nospam2000/Greaseweazle-F7-Plus/(list of files, drawings)

Other design files:
V2/Greaseweazle_F7_Plus_V2.dsn
