nospam2000/Greaseweazle-F7-Plus/V2/Greaseweazle_F7_Plus_V2.kicad_pcb

## KiCad design V2/Greaseweazle_F7_Plus_V2.kicad_pcb (2021-01-13)

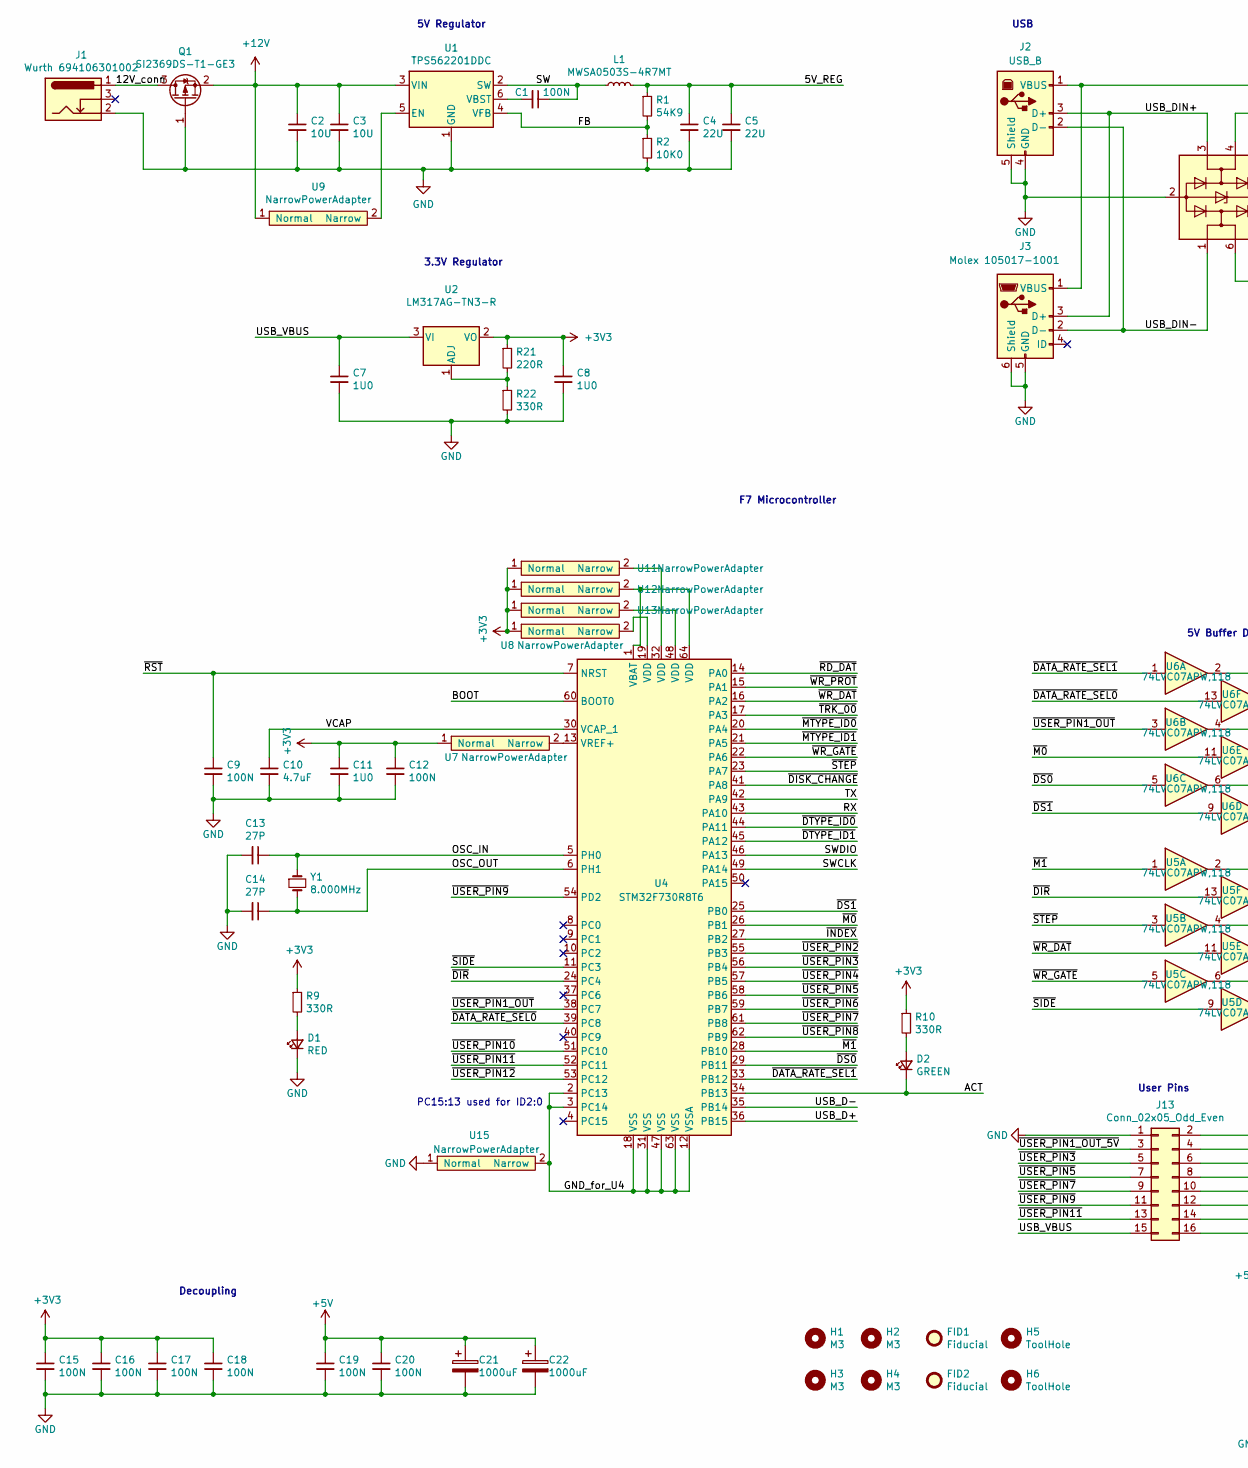
[picture p1: schematic Greaseweazle_F7_Plus_V2.sch, Greaseweazle F7 Plus, part in row 1, column 1]

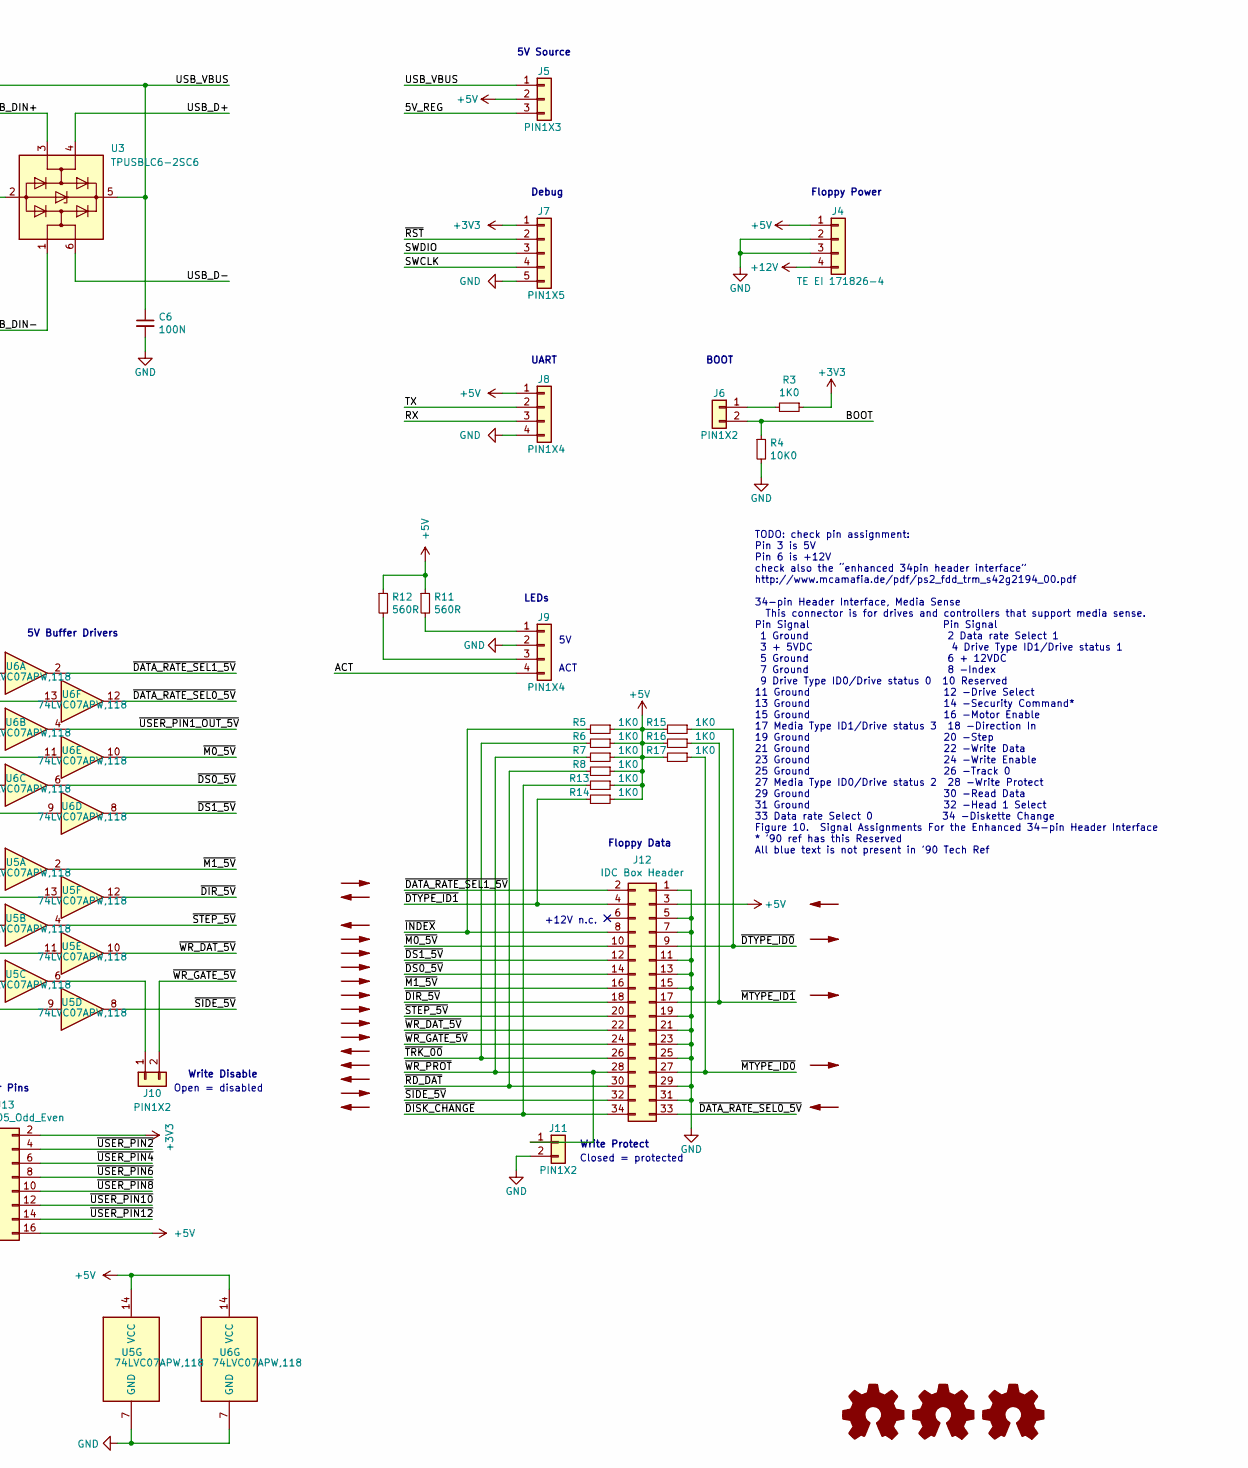
[picture p2: schematic Greaseweazle_F7_Plus_V2.sch, Greaseweazle F7 Plus, part in row 1, column 2]

Parts:
C1, C6, C9, C12, C15, C16, C17, C18, C19, C20: 100N; C_0402_1005Metric; MFR.Part CL05B104KO5NNNC; LCSC C1525
C2, C3: 10U; C_0805_2012Metric; MFR.Part CL21A106KAYNNNE; LCSC C15850
C4, C5: 22U; C_0805_2012Metric; MFR.Part CL21A226MAQNNNE; LCSC C45783
C7, C8, C11: 1U0; C_0402_1005Metric; MFR.Part CL05A105KA5NQNC; LCSC C52923
C10: 4.7uF; C_0805_2012Metric; MFR.Part CL21A475KAQNNNE; LCSC C1779
C13, C14: 27P; C_0402_1005Metric; MFR.Part 0402CG270J500NTN; LCSC C1557
C21, C22: 1000uF; CP_Radial_D10.0mm_P5.00mm
D1: RED; LED_0603_1608Metric; MFR.Part KT-0603R; LCSC C2286
D2: GREEN; LED_0603_1608Metric; MFR.Part 19-217/GHC-YR1S2/3T; LCSC C72043
FID1, FID2: Fiducial; Fiducial_1mm_Mask2mm
H1, H2, H3, H4: M3; MountingHole_3mm
H5, H6: ToolHole; ToolingHole_1.152mm
J1: Wurth 694106301002; BarrelJack_Horizontal
J2: USB_B; USB_B_OST_USB-B1HSxx_Horizontal
J3: Molex 105017-1001; USB_Micro-B_Molex-105017-0001
J4: TE EI 171826-4; TE_171826-4_1x4_P2.50mm_Horizontal
J5: PIN1X3; PinHeader_1x03_P2.54mm_Vertical
J6, J10, J11: PIN1X2; PinHeader_1x02_P2.54mm_Vertical
J7: PIN1X5; PinHeader_1x05_P2.54mm_Vertical
J8, J9: PIN1X4; PinHeader_1x04_P2.54mm_Vertical
J12: IDC Box Header; IDC-Header_2x17_P2.54mm_Vertical
J13: Conn_02x05_Odd_Even; PinHeader_2x08_P2.54mm_Vertical
L1: MWSA0503S-4R7MT; L_5.4x5.2_H2.8; MFR.Part MWSA0503S-4R7MT; LCSC C408410
LOGO1: OSHW Logo; OSHW-Logo2_7.3x6mm_SilkScreen
LOGO2: GW Logo; Greaseweazle_Logo_small
LOGO3: GW Logo; Symbol_Barrel_Polarity
Q1: SI2369DS-T1-GE3; SOT-23; MFR.Part SI2369DS-T1-GE3; LCSC C141546
R1: 54K9; R_0603_1608Metric; MFR.Part 0603WAF5492T5E; LCSC C23077
R2, R4: 10K0; R_0603_1608Metric; MFR.Part 0603WAF1002T5E; LCSC C25804
R3, R5, R6, R7, R8, R13, R14, R15, R16, R17: 1K0; R_0805_2012Metric; MFR.Part 0805W8F1001T5E; LCSC C17513
R9, R10, R22: 330R; R_0805_2012Metric; MFR.Part 0805W8F3300T5E; LCSC C17630
R11, R12: 560R; R_0805_2012Metric; MFR.Part 0805W8F5600T5E; LCSC C28636
R21: 220R; R_0805_2012Metric; MFR.Part 0805W8F2200T5E; LCSC C17557
U1: TPS562201DDC; SOT-23-6; MFR.Part TPS562201DDCR; LCSC C90061
U2: LM317AG-TN3-R; TO-252-2; MFR.Part LM317AG-TN3-R; LCSC C75510
U3: TPUSBLC6-2SC6; SOT-23-6; MFR.Part TPUSBLC6-2SC6; LCSC C558442
U4: STM32F730R8T6; LQFP-64_10x10mm_P0.5mm; MFR.Part STM32F730R8T6; LCSC C478453
U5, U6: 74LVC07APW,118; TSSOP-14_4.4x5mm_P0.65mm; MFR.Part 74LVC07APW,118; LCSC C6051
U7, U8, U9, U11, U12, U13: NarrowPowerAdapter; NarrowPowerAdapter_0.60_to_0.25
U15: NarrowPowerAdapter; NarrowPowerAdapter_0.60_to_0.25_thick
Y1: 8.000MHz; Crystal_SMD_5032-2Pin_5.0x3.2mm; MFR.Part X50328MSB2GI; LCSC C115962

Connections:
+3V3: C8.1, C11.1, C12.1, C15.1, C16.1, C17.1, C18.1, J7.1, J13.2, R3.1, R9.1, R10.1, R21.1, U2.2 (VO), U7.1 (Normal), U8.1 (Normal), U11.1 (Normal), U12.1 (Normal), U13.1 (Normal)
+5V: C19.1, C20.1, C21.1, C22.1, J4.1, J5.2, J8.1, J12.3, J13.16, R5.1, R6.1, R7.1, R8.1, R11.1, R12.1, R13.1, R14.1, R15.2, R16.2, R17.2, U5.14 (VCC), U6.14 (VCC)
+12V: C2.1, C3.1, J4.4, Q1.2 (S), U1.3 (VIN), U9.1 (Normal)
/5V_REG: C4.1, C5.1, J5.3, L1.2, R1.1
/12V_conn: J1.1, Q1.3 (D)
/ACT: D2.1 (K), J9.4, U4.34 (PB13)
/BOOT: J6.2, R4.1, U4.60 (BOOT0)
/FB: R1.2, R2.1, U1.4 (VFB)
/GND_for_U4: U4.2 (PC13), U4.3 (PC14), U4.12 (VSSA), U4.18 (VSS), U4.31 (VSS), U4.47 (VSS), U4.63 (VSS), U15.2 (Narrow)
/OSC_IN: C13.1, U4.5 (PH0), Y1.1
/OSC_OUT: C14.1, U4.6 (PH1), Y1.2
/RX: J8.3, U4.43 (PA10)
/SW: C1.1, L1.1, U1.2 (SW)
/SWCLK: J7.4, U4.49 (PA14)
/SWDIO: J7.3, U4.46 (PA13)
/TX: J8.2, U4.42 (PA9)
/USB_D+: U3.4 (I/O2), U4.36 (PB15)
/USB_D-: U3.6 (I/O1), U4.35 (PB14)
/USB_DIN+: J2.3 (D+), J3.3 (D+), U3.3 (I/O2)
/USB_DIN-: J2.2 (D-), J3.2 (D-), U3.1 (I/O1)
/USB_VBUS: C6.1, C7.1, J2.1 (VBUS), J3.1 (VBUS), J5.1, J13.15, U2.3 (VI), U3.5 (VBUS)
/VCAP: C10.1, U4.30 (VCAP_1)
/~DATA_RATE_SEL0_5V~: J12.33, U6.12
/~DATA_RATE_SEL0~: U4.39 (PC8), U6.13
/~DATA_RATE_SEL1_5V~: J12.2, U6.2
/~DATA_RATE_SEL1~: U4.33 (PB12), U6.1
/~DIR_5V~: J12.18, U5.12
/~DIR~: U4.24 (PC4), U5.13
/~DISK_CHANGE~: J12.34, R13.2, U4.41 (PA8)
/~DS0_5V~: J12.14, U6.6
/~DS0~: U4.29 (PB11), U6.5
/~DS1_5V~: J12.12, U6.8
/~DS1~: U4.25 (PB0), U6.9
/~DTYPE_ID0~: J12.9, R15.1, U4.44 (PA11)
/~DTYPE_ID1~: J12.4, R14.2, U4.45 (PA12)
/~INDEX~: J12.8, R5.2, U4.27 (PB2)
/~M0_5V~: J12.10, U6.10
/~M0~: U4.26 (PB1), U6.11
/~M1_5V~: J12.16, U5.2
/~M1~: U4.28 (PB10), U5.1
/~MTYPE_ID0~: J12.27, R17.1, U4.20 (PA4)
/~MTYPE_ID1~: J12.17, R16.1, U4.21 (PA5)
/~RD_DAT~: J12.30, R8.2, U4.14 (PA0)
/~RST~: C9.1, J7.2, U4.7 (NRST)
/~SIDE_5V~: J12.32, U5.8
/~SIDE~: U4.11 (PC3), U5.9
/~STEP_5V~: J12.20, U5.4
/~STEP~: U4.23 (PA7), U5.3
/~TRK_00~: J12.26, R6.2, U4.17 (PA3)
/~USER_PIN1_OUT_5V~: J13.3, U6.4
/~USER_PIN1_OUT~: U4.38 (PC7), U6.3
/~USER_PIN2~: J13.4, U4.55 (PB3)
/~USER_PIN3~: J13.5, U4.56 (PB4)
/~USER_PIN4~: J13.6, U4.57 (PB5)
/~USER_PIN5~: J13.7, U4.58 (PB6)
/~USER_PIN6~: J13.8, U4.59 (PB7)
/~USER_PIN7~: J13.9, U4.61 (PB8)
/~USER_PIN8~: J13.10, U4.62 (PB9)
/~USER_PIN9~: J13.11, U4.54 (PD2)
/~USER_PIN10~: J13.12, U4.51 (PC10)
/~USER_PIN11~: J13.13, U4.52 (PC11)
/~USER_PIN12~: J13.14, U4.53 (PC12)
/~WR_DAT_5V~: J12.22, U5.10
/~WR_DAT~: U4.16 (PA2), U5.11
/~WR_GATE_5V~: J10.2, J12.24
/~WR_GATE~: U4.22 (PA6), U5.5
/~WR_PROT~: J11.1, J12.28, R7.2, U4.15 (PA1)
GND: C2.2, C3.2, C4.2, C5.2, C6.2, C7.2, C8.2, C9.2, C10.2, C11.2, C12.2, C13.2, C14.2, C15.2, C16.2, C17.2, C18.2, C19.2, C20.2, C21.2, C22.2, D1.1 (K), J1.2, J2.4 (GND), J2.5 (Shield), J3.5 (GND), J3.6 (Shield), J4.2, J4.3, J7.5, J8.4, J9.2, J11.2, J12.1, J12.5, J12.7, J12.11, J12.13, J12.15, J12.19, J12.21, J12.23, J12.25, J12.29, J12.31, J13.1, Q1.1 (G), R2.2, R4.2, R22.2, U1.1 (GND), U3.2 (GND), U5.7 (GND), U6.7 (GND), U15.1 (Normal)
unnamed: C1.2, U1.6 (VBST)
unnamed: D1.2 (A), R9.2
unnamed: D2.2 (A), R10.2
unnamed: J6.1, R3.2
unnamed: J9.1, R11.2
unnamed: J9.3, R12.2
unnamed: J10.1, U5.6
unnamed: R21.2, R22.1, U2.1 (ADJ)
unnamed: U1.5 (EN), U9.2 (Narrow)
unnamed: U4.13 (VREF+), U7.2 (Narrow)
unnamed: U4.19 (VDD), U8.2 (Narrow)
unnamed: U4.32 (VDD), U11.2 (Narrow)
unnamed: U4.1 (VBAT), U4.64 (VDD), U12.2 (Narrow)
unnamed: U4.48 (VDD), U13.2 (Narrow)

Notes on the sheet:
UART
Debug
Floppy Power
BOOT
USB
Floppy Data
5V Regulator
5V Buffer Drivers
3.3V Regulator
5V Source
F7 Microcontroller
Decoupling
LEDs
PC15:13 used for ID2:0
ACT
Write Protect
Write Disable
Open = disabled
Closed = protected
TODO: check pin assignment: Pin 3 is 5V Pin 6 is +12V check also the “enhanced 34pin header interface” http://www.mcamafia.de/pdf/ps2_fdd_trm_s42g2194_00.pdf 34-pin Header Interface, Media Sense This connector is for drives and controllers that support media sense. Pin Signal Pin Signal 1 Ground 2 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
+12V n.c.
User Pins

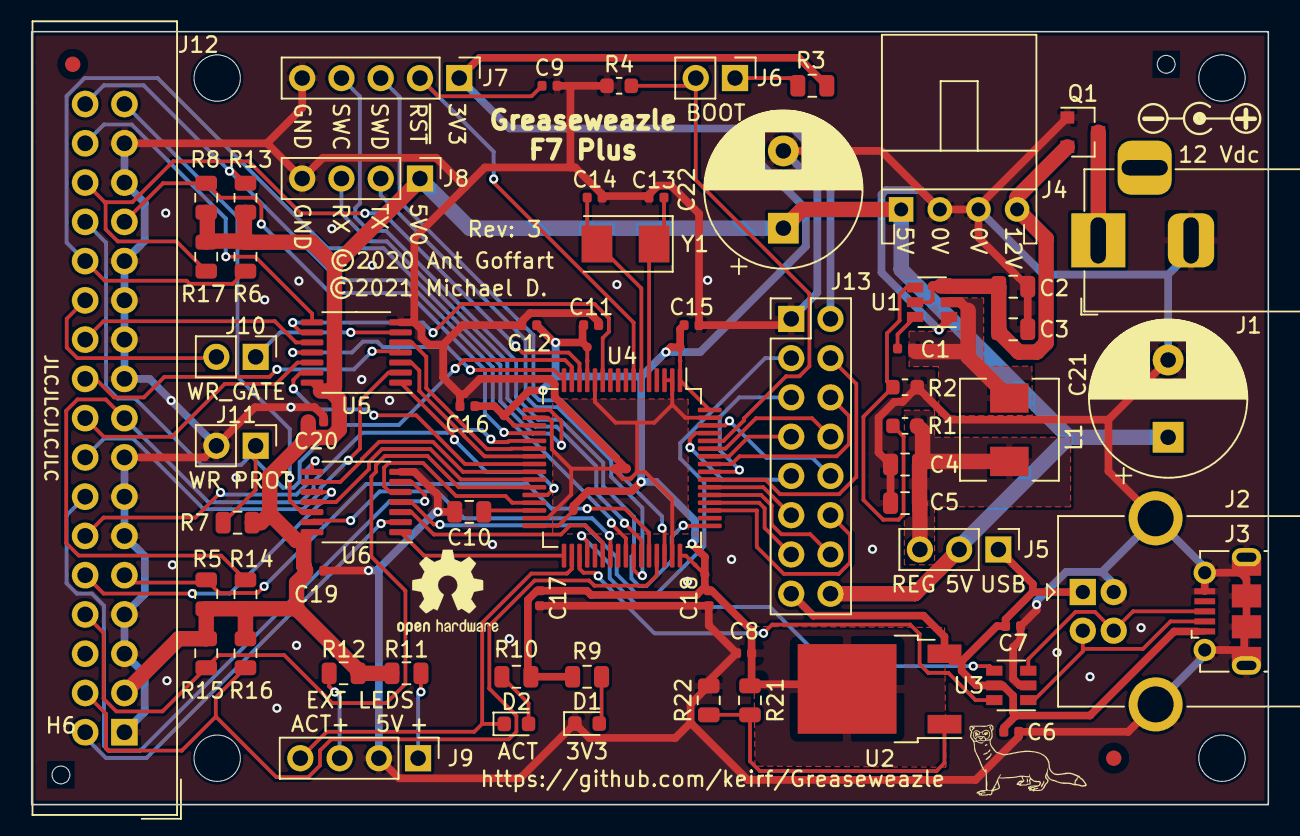
[picture p3: board Greaseweazle_F7_Plus_V2.kicad_pcb from above]

Board: 2 copper layers, 80.0 x 50.0 mm, 83 parts (0 on the bottom side), 82 nets.
