nospam2000/Greaseweazle-F7-Plus/(commit log)

2021-01-06 added JLCPBC component ids, adapted footprints changed components which are no available in JLCPCB catalog
    [Greaseweazle_F7_Plus_V2.sch, Greaseweazle_F7_Plus_V2_BOM.csv]
2021-01-07 made autorouting possible use components which are in stock on JLCPCB
    [Greaseweazle_F7_Plus_V2-B_Cu.gbr, Greaseweazle_F7_Plus_V2-B_Mask.gbr, Greaseweazle_F7_Plus_V2-Edge_Cuts.gbr, Greaseweazle_F7_Plus_V2-F_Cu.gbr, Greaseweazle_F7_Plus_V2-F_Mask.gbr, Greaseweazle_F7_Plus_V2-F_Paste.gbr, Greaseweazle_F7_Plus_V2-F_SilkS.gbr, Greaseweazle_F7_Plus_V2-NPTH.drl]
2021-01-07 fixed rotation of U3
    [Greaseweazle_F7_Plus_V2-top-pos_fixed.csv]
2021-01-08 fixed copper fill zones
    [Greaseweazle_F7_Plus_V2-B_Cu.gbr, Greaseweazle_F7_Plus_V2-B_Mask.gbr, Greaseweazle_F7_Plus_V2-Edge_Cuts.gbr, Greaseweazle_F7_Plus_V2-F_Cu.gbr, Greaseweazle_F7_Plus_V2-F_Mask.gbr, Greaseweazle_F7_Plus_V2-F_Paste.gbr, Greaseweazle_F7_Plus_V2-F_SilkS.gbr, Greaseweazle_F7_Plus_V2-NPTH.drl]
2021-01-08 decreased keep out area around tooling holes
    [Greaseweazle_F7_Plus_V2.kicad_pcb]
2021-01-08 changed copper zone pad connection of L1 to "thermal reliefs"
    [Greaseweazle_F7_Plus_V2.kicad_pcb]
2021-01-08 added copper fill below mcu and L1 improved power connections of mcu
    [Greaseweazle_F7_Plus_V2.dsn, Greaseweazle_F7_Plus_V2.kicad_pcb, Greaseweazle_F7_Plus_V2.sch]
2021-01-08 added via to get better copper fill made 5Vreg thicker
    [Greaseweazle_F7_Plus_V2.kicad_pcb]
2021-01-08 updated production output files
    [Greaseweazle_F7_Plus_V2-B_Cu.gbr, Greaseweazle_F7_Plus_V2-B_Mask.gbr, Greaseweazle_F7_Plus_V2-Edge_Cuts.gbr, Greaseweazle_F7_Plus_V2-F_Cu.gbr, Greaseweazle_F7_Plus_V2-F_Mask.gbr, Greaseweazle_F7_Plus_V2-F_Paste.gbr, Greaseweazle_F7_Plus_V2-F_SilkS.gbr, Greaseweazle_F7_Plus_V2-NPTH.drl]
2021-01-09 changed C10 from 10u to 4.7u according to STM doc changed 74LS07 to 74LVC07APW,118 to reduce cost
    [Greaseweazle_F7_Plus_V2.dsn, Greaseweazle_F7_Plus_V2.kicad_pcb, Greaseweazle_F7_Plus_V2.sch]
2021-01-09 routed latest version
    [Greaseweazle_F7_Plus_V2.kicad_pcb]
2021-01-09 production files for latest version
    [Greaseweazle_F7_Plus_V2-B_Cu.gbr, Greaseweazle_F7_Plus_V2-B_Mask.gbr, Greaseweazle_F7_Plus_V2-Edge_Cuts.gbr, Greaseweazle_F7_Plus_V2-F_Cu.gbr, Greaseweazle_F7_Plus_V2-F_Mask.gbr, Greaseweazle_F7_Plus_V2-F_Paste.gbr, Greaseweazle_F7_Plus_V2-F_SilkS.gbr, Greaseweazle_F7_Plus_V2-NPTH.drl]
2021-01-09 replaced 3.3V regulator by cheaper one moved many parts to make space
    [Greaseweazle_F7_Plus_V2-B_Cu.gbr, Greaseweazle_F7_Plus_V2-B_Mask.gbr, Greaseweazle_F7_Plus_V2-Edge_Cuts.gbr, Greaseweazle_F7_Plus_V2-F_Cu.gbr, Greaseweazle_F7_Plus_V2-F_Mask.gbr, Greaseweazle_F7_Plus_V2-F_Paste.gbr, Greaseweazle_F7_Plus_V2-F_SilkS.gbr, Greaseweazle_F7_Plus_V2-NPTH.drl]
2021-01-09 added 2nd CMT file to remove 5V regulator to save cost rotated U2 back by 180° added vias to get better copperfill
    [Greaseweazle_F7_Plus_V2-B_Cu.gbr, Greaseweazle_F7_Plus_V2-B_Mask.gbr, Greaseweazle_F7_Plus_V2-Edge_Cuts.gbr, Greaseweazle_F7_Plus_V2-F_Cu.gbr, Greaseweazle_F7_Plus_V2-F_Mask.gbr, Greaseweazle_F7_Plus_V2-F_Paste.gbr, Greaseweazle_F7_Plus_V2-F_SilkS.gbr, Greaseweazle_F7_Plus_V2-NPTH.drl]
2021-01-09 added 3x 10000uF caps to buffer motor start of floppy which can draw up to 1A
    [Greaseweazle_F7_Plus_V2-B_Cu.gbr, Greaseweazle_F7_Plus_V2-B_Mask.gbr, Greaseweazle_F7_Plus_V2-Edge_Cuts.gbr, Greaseweazle_F7_Plus_V2-F_Cu.gbr, Greaseweazle_F7_Plus_V2-F_Mask.gbr, Greaseweazle_F7_Plus_V2-F_Paste.gbr, Greaseweazle_F7_Plus_V2-F_SilkS.gbr, Greaseweazle_F7_Plus_V2-NPTH.drl]
2021-01-09 fixed copyright and greaseweazel silk
    [Greaseweazle_F7_Plus_V2-B_Cu.gbr, Greaseweazle_F7_Plus_V2-B_Mask.gbr, Greaseweazle_F7_Plus_V2-Edge_Cuts.gbr, Greaseweazle_F7_Plus_V2-F_Cu.gbr, Greaseweazle_F7_Plus_V2-F_Mask.gbr, Greaseweazle_F7_Plus_V2-F_Paste.gbr, Greaseweazle_F7_Plus_V2-F_SilkS.gbr, Greaseweazle_F7_Plus_V2-NPTH.drl]
2021-01-09 moved U11 NarrowPowCon to get better routing
    [Greaseweazle_F7_Plus_V2-B_Cu.gbr, Greaseweazle_F7_Plus_V2-B_Mask.gbr, Greaseweazle_F7_Plus_V2-Edge_Cuts.gbr, Greaseweazle_F7_Plus_V2-F_Cu.gbr, Greaseweazle_F7_Plus_V2-F_Mask.gbr, Greaseweazle_F7_Plus_V2-F_Paste.gbr, Greaseweazle_F7_Plus_V2-F_SilkS.gbr, Greaseweazle_F7_Plus_V2-NPTH.drl]
2021-01-10 fixed footprint+silk of polarized caps
    [Greaseweazle_F7_Plus_V2-B_Cu.gbr, Greaseweazle_F7_Plus_V2-B_Mask.gbr, Greaseweazle_F7_Plus_V2-Edge_Cuts.gbr, Greaseweazle_F7_Plus_V2-F_Cu.gbr, Greaseweazle_F7_Plus_V2-F_Mask.gbr, Greaseweazle_F7_Plus_V2-F_Paste.gbr, Greaseweazle_F7_Plus_V2-F_SilkS.gbr, Greaseweazle_F7_Plus_V2-NPTH.drl]
2021-01-10 added silk for powerconn polarity
    [Greaseweazle_F7_Plus_V2-B_Cu.gbr, Greaseweazle_F7_Plus_V2-B_Mask.gbr, Greaseweazle_F7_Plus_V2-Edge_Cuts.gbr, Greaseweazle_F7_Plus_V2-F_Cu.gbr, Greaseweazle_F7_Plus_V2-F_Mask.gbr, Greaseweazle_F7_Plus_V2-F_Paste.gbr, Greaseweazle_F7_Plus_V2-F_SilkS.gbr, Greaseweazle_F7_Plus_V2-NPTH.drl]
2021-01-10 use enhanced floppy interface
    use this document as reference: http://www.mcamafia.de/pdf/ps2_fdd_trm_s42g2194_00.pdf
    IBM Personal System/2
    3.5inch Diskette drives
    Technical Reference 42G2194 S42G-2194-00
    This version is no longer compatible to original firmware because
    some connections changed
    support additionally the following pins:
    media type ID 0+1
    drive type ID 0+1
    data rate selection 0+1
    disk change
    +5V (must be set using the "V5 Source" jumper J5)
    removed connection from 7407 to pin6 (this is +12V)
    pin 4 is now input instead of output
    [Greaseweazle_F7_Plus_V2-B_Cu.gbr, Greaseweazle_F7_Plus_V2-B_Mask.gbr, Greaseweazle_F7_Plus_V2-Edge_Cuts.gbr, Greaseweazle_F7_Plus_V2-F_Cu.gbr, Greaseweazle_F7_Plus_V2-F_Mask.gbr, Greaseweazle_F7_Plus_V2-F_Paste.gbr, Greaseweazle_F7_Plus_V2-F_SilkS.gbr, Greaseweazle_F7_Plus_V2-NPTH.drl]
2021-01-10 moved components to optimize routing
    [Greaseweazle_F7_Plus_V2-B_Cu.gbr, Greaseweazle_F7_Plus_V2-B_Mask.gbr, Greaseweazle_F7_Plus_V2-Edge_Cuts.gbr, Greaseweazle_F7_Plus_V2-F_Cu.gbr, Greaseweazle_F7_Plus_V2-F_Mask.gbr, Greaseweazle_F7_Plus_V2-F_Paste.gbr, Greaseweazle_F7_Plus_V2-F_SilkS.gbr, Greaseweazle_F7_Plus_V2-NPTH.drl]
2021-01-10 optimized silk of R's on the left side
    [Greaseweazle_F7_Plus_V2.kicad_pcb]
2021-01-10 updated production files
    [Greaseweazle_F7_Plus_V2-B_Cu.gbr, Greaseweazle_F7_Plus_V2-B_Mask.gbr, Greaseweazle_F7_Plus_V2-Edge_Cuts.gbr, Greaseweazle_F7_Plus_V2-F_Cu.gbr, Greaseweazle_F7_Plus_V2-F_Mask.gbr, Greaseweazle_F7_Plus_V2-F_Paste.gbr, Greaseweazle_F7_Plus_V2-F_SilkS.gbr, Greaseweazle_F7_Plus_V2-NPTH.drl]
2021-01-10 added changed pin definitions
2021-01-13 added user pin connector removed C23
    [Greaseweazle_F7_Plus_V2-B_Cu.gbr, Greaseweazle_F7_Plus_V2-B_Mask.gbr, Greaseweazle_F7_Plus_V2-Edge_Cuts.gbr, Greaseweazle_F7_Plus_V2-F_Cu.gbr, Greaseweazle_F7_Plus_V2-F_Mask.gbr, Greaseweazle_F7_Plus_V2-F_Paste.gbr, Greaseweazle_F7_Plus_V2-F_SilkS.gbr, Greaseweazle_F7_Plus_V2-NPTH.drl]
2021-01-13 moved user pin conn and voltage reg to make more space for the casing of the user pin conn
    [Greaseweazle_F7_Plus_V2-B_Cu.gbr, Greaseweazle_F7_Plus_V2-B_Mask.gbr, Greaseweazle_F7_Plus_V2-Edge_Cuts.gbr, Greaseweazle_F7_Plus_V2-F_Cu.gbr, Greaseweazle_F7_Plus_V2-F_Mask.gbr, Greaseweazle_F7_Plus_V2-F_Paste.gbr, Greaseweazle_F7_Plus_V2-F_SilkS.gbr, Greaseweazle_F7_Plus_V2-NPTH.drl]
