nospam2000/Greaseweazle-F7-Plus/(notices)

Notices in the files:
V2/Greaseweazle_F7_Plus_V2.kicad_pcb:
©2021 Michael D.
©2020 Ant Goffart
